AleSuky/SkP32v1.1/SW/Ejemplos/Microchip/USB/Documentation/images/LPCDK-J14.jpg

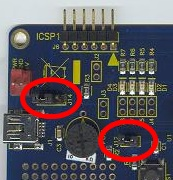
SW/Ejemplos/Microchip/USB/Documentation/images/LPCDK-J14.jpg
