AleSuky/SkP32v1.1/SW/Ejemplos/Microchip/USB/Documentation/images/FSUSBsw2.jpg

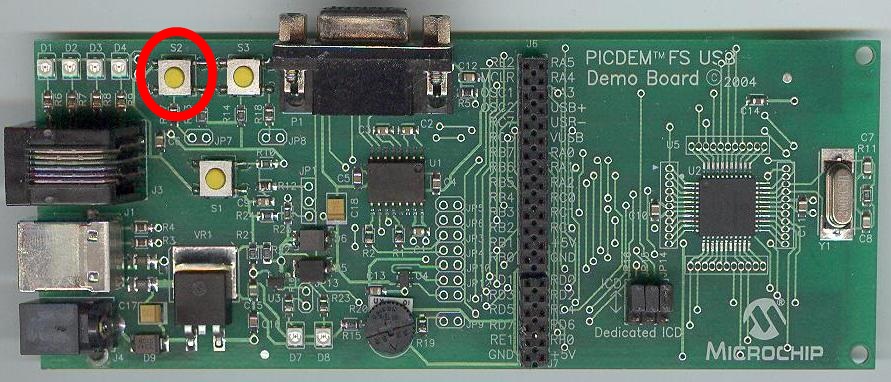
SW/Ejemplos/Microchip/USB/Documentation/images/FSUSBsw2.jpg
