AleSuky/SkP32v1.1/README.md

<b>SkP32</b>

<p>SkP32 es una placa desarrollo para PIC32MX3/4 y PIC24 con package TQFP100. Ha sido pensada especialmente para un PIC32, 
pero gracias a que Microchip mantiene el pinout entre familias, podemos decir que hay seguramente un 95% de compatibilidad 
para los PIC24.</p>

Las características de la misma son:

<ul>
<li type="square">Microcontrolador PIC32MX3/4 o PIC24</li>
<li type="square">Reguladores de 5.0 y 3.3 V.</li>
<li type="square">Alimentación externa o mediante USB.</li>
<li type="square">Header con disponibilidad de todos los pines del microcontrolador.</li>
<li type="square">Header para UART1 y UART2.</li>
<li type="square">Header para I2C1 e I2C2.</li>
<li type="square">Header para SPI1 y SPI2.</li>
<li type="square">Header para pines I/O RB0-RB7 (8-bits).</li>
<li type="square">Header para LCD TFT</li>
<li type="square">4 Leds on board habilitable mediantejumpers.</li>
<li type="square">2 Switch on board habilitable mediantejumpers.</li>
<li type="square">1 Potenciometro on board habilitable mediante jumper</li>
<li type="square">Para PIC con USB, conector mini-USB device</li>
<li type="square">Para PIC con USB, USB-A Host con TPS2041B para control sobre corriente.</li>
<li type="square">Zócalo para SD Card.</li>
<li type="square">Memoria EEPRON SPI (3.3 V).</li>
<li type="square">Cristal de 32768 Hz para RTC interno.</li>
<li type="square">Header para conexión ISCP.</li>
</ul>

<b>Ejemplos provistos:</b>
<ul>
<li type="square">Bootloader USB</li>
<li type="square">AVI_Player</li>	
<li type="square">FM25L16	</li>
<li type="square">FreeRTOS LCD</li>	
<li type="square">FreeRTOS Plantilla</li>
<li type="square">FSFatTest (FatFs by ChaN)</li>
<li type="square">Modbus Test (freeMODBUS)</li>	
<li type="square">Plantilla	</li>
<li type="square">RTC	</li>
<li type="square">SDCard	</li>
<li type="square">SST25VF016	</li>
<li type="square">TCPIP	</li>
<li type="square">TFT+ADC	</li>
<li type="square">TFT+Touch	</li>
<li type="square">UART</li>	
<li type="square">USB-CDC	</li>
<li type="square">USB-HID	</li>
<li type="square">USB-HOST_Mass_Storag</li>
<li type="square">USB-MST</li>
</ul>

<p>Copyright © Micros-Designs.com.ar</p>
