AleSuky/SkP32v1.1/HW/Eagle/SkP32v1.1.jpg

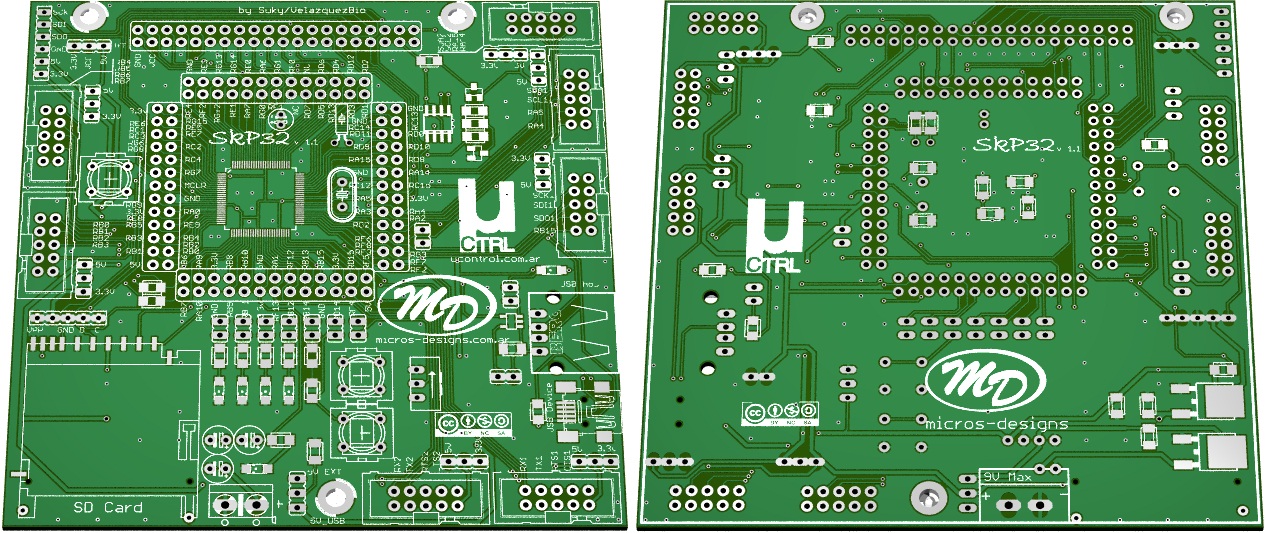
HW/Eagle/SkP32v1.1.jpg
