AleSuky/SkP32v1.1/SW/Ejemplos/Microchip/USB/Documentation/images/android_custom_hid.png

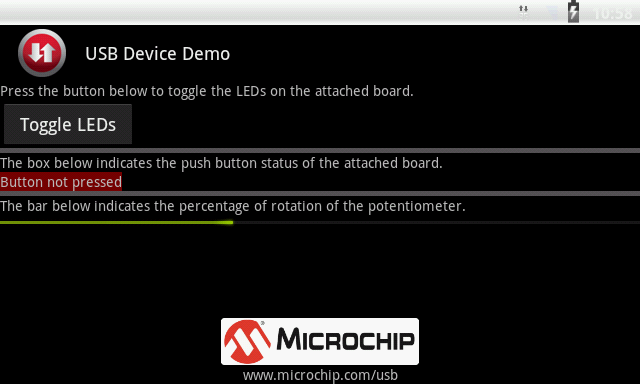
SW/Ejemplos/Microchip/USB/Documentation/images/android_custom_hid.png
