AleSuky/SkP32v1.1/SW/Ejemplos/Microchip/USB/Documentation/images/android_no_device.png

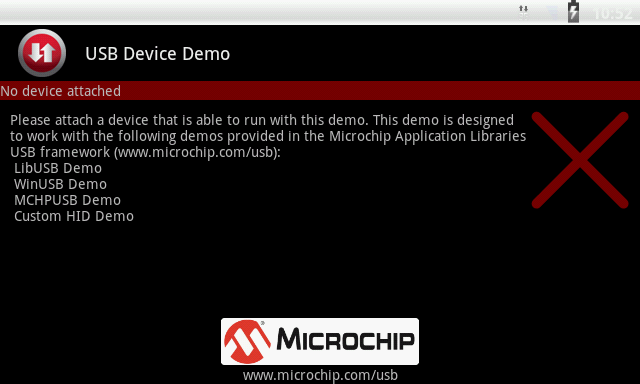
SW/Ejemplos/Microchip/USB/Documentation/images/android_no_device.png
