AleSuky/SkP32v1.1/SW/Ejemplos/Microchip/USB/Documentation/images/Application ld script.png

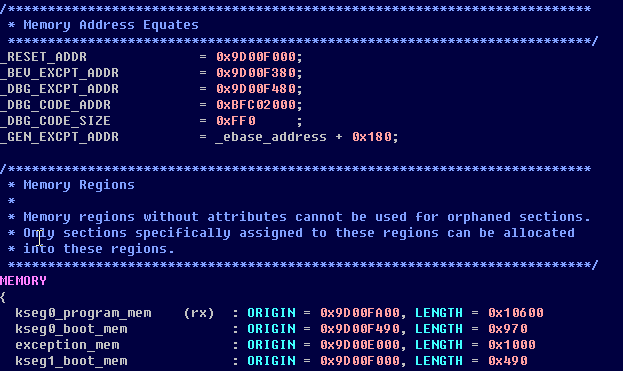
SW/Ejemplos/Microchip/USB/Documentation/images/Application ld script.png
