AleSuky/SkP32v1.1/SW/Ejemplos/Microchip/USB/Documentation/images/microchip_android_home.png

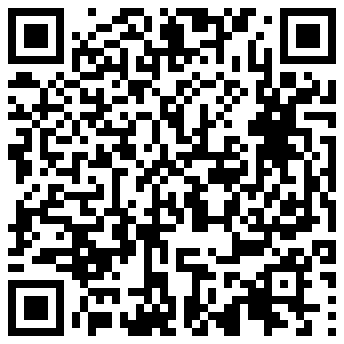
SW/Ejemplos/Microchip/USB/Documentation/images/microchip_android_home.png
