AleSuky/SkP32v1.1/SW/Ejemplos/Microchip/USB/Printer Host Driver/Documentation/Printer Study.xls

Sheet: Printers
Printer Languages Used By Popular Printers
Manufacturer | Model | Type | Cost | Not Available | Host-based | Epson Emulation | CPCL | DPL | EPL2 | ESC | ESC/P | ESC/P2 | ESC/POS | GDI | IBM 2380 Emulation | LIDIL | Okidata MICROLINE | PCL 3 | PCL 3 enhanced | PCL 3 GUI | PCL 5e | PCL 6/XL | PCL 10 (?) | PostScript 3 | PPDS | SPL or SPL-C | ZPL II
Count |  |  |  | 40 | 8 | 4 | 3 | 0 | 1 | 1 | 4 | 2 | 24 | 2 | 1 | 8 | 4 | 4 | 5 | 7 | 7 | 12 | 1 | 6 | 5 | 3 | 4
HP | Deskjet D2430 | Inkjet | $40 |  |  |  |  |  |  |  |  |  |  |  |  | X |  |  |  |  |  |  |  |  |  |  |  | Color Laser
HP | Deskjet D2530 | Inkjet | $40 |  |  |  |  |  |  |  |  |  |  |  |  |  |  |  |  | X |  |  |  |  |  |  |  | Dot Matrix Receipt
HP | Deskjet D2560 | Inkjet | $50 |  |  |  |  |  |  |  |  |  |  |  |  |  |  |  |  | X |  |  |  |  |  |  |  | Embedded
HP | Deskjet D2460 | Inkjet | $50 |  |  |  |  |  |  |  |  |  |  |  |  | X |  |  |  |  |  |  |  |  |  |  |  | Impact
HP | Deskjet D4260 | Inkjet | $70 |  |  |  |  |  |  |  |  |  |  |  |  | X |  |  |  |  |  |  |  |  |  |  |  | Inkjet
HP | Deskjet D1560 | Inkjet | $70 |  |  |  |  |  |  |  |  |  |  |  |  | X |  |  |  |  |  |  |  |  |  |  |  | Inkjet All-In-One
HP | Deskjet D1455 | Inkjet | $70 |  |  |  |  |  |  |  |  |  |  |  |  | X |  |  |  |  |  |  |  |  |  |  |  | Inkjet Receipt
HP | Deskjet 460c | Mobile | $250 |  |  |  |  |  |  |  |  |  |  |  |  |  |  |  | X |  |  |  |  |  |  |  |  | Laser
HP | Deskjet 470 | Mobile | $250 |  |  |  |  |  |  |  |  |  |  |  |  |  |  |  | X |  |  |  |  |  |  |  |  | Laser All-In-One
HP | Photosmart D5360 | Inkjet | $90 |  |  |  |  |  |  |  |  |  |  |  |  |  |  |  | X |  |  |  |  |  |  |  |  | Mobile
HP | Deskjet F4180 | Inkjet All-In-One | $80 |  |  |  |  |  |  |  |  |  |  |  |  | X |  |  |  |  |  |  |  |  |  |  |  | Mobile Receipt
HP | Deskjet 6940 | Inkjet | $110 | X |  |  |  |  |  |  |  |  |  |  |  |  |  |  |  |  |  |  |  |  |  |  |  | Photo Only
HP | Photosmart C4280 | Inkjet All-In-One | $100 | X |  |  |  |  |  |  |  |  |  |  |  |  |  |  |  |  |  |  |  |  |  |  |  | POS
HP | Photosmart C5280 | Inkjet All-In-One | $130 |  |  |  |  |  |  |  |  |  |  |  |  |  |  |  |  | X |  |  |  |  |  |  |  | Specialty
HP | Photosmart D7260 | Inkjet | $130 |  |  |  |  |  |  |  |  |  |  |  |  |  |  | X |  |  |  |  |  |  |  |  |  | Thermal
HP | Photosmart D7460 | Inkjet | $150 |  |  |  |  |  |  |  |  |  |  |  |  |  |  |  |  | X |  |  |  |  |  |  |  | Thermal Label
HP | Photosmart C4385 | Inkjet All-In-One | $130 |  |  |  |  |  |  |  |  |  |  |  |  |  |  | X |  | X |  |  | X |  |  |  |  | Thermal Receipt
HP | Deskjet 6988 | Inkjet | $130 |  |  |  |  |  |  |  |  |  |  |  |  |  |  | X
HP | Photosmart A526 | Photo Only | $100 |  |  |  |  |  |  |  |  |  |  |  |  |  |  | X
HP | Photosmart A440 | Photo Only | $100 |  |  |  |  |  |  |  |  |  |  |  |  |  |  |  |  | X
HP | Officejet 4315 | Inkjet All-In-One | $90 | X
HP | Officejet J3680 | Inkjet All-In-One | $90 |  |  |  |  |  |  |  |  |  |  |  |  | X
HP | Officejet J4580 | Inkjet All-In-One | $110 |  |  |  |  |  |  |  |  |  |  |  |  |  |  |  |  | X
HP | Officejet 5610 | Inkjet All-In-One | $110 |  |  |  |  |  |  |  |  |  |  |  |  | X
HP | Officejet Pro K5400 | Inkjet | $150 |  |  |  |  |  |  |  |  |  |  |  |  |  |  |  | X
HP | LaserJet P1005 | Laser | $130 |  | X
HP | Color LaserJet 1600 | Color Laser | $300 |  | X
HP | Officejet J5780 | Inkjet All-In-One | $150 |  |  |  |  |  |  |  |  |  |  |  |  |  |  |  | X
HP | Laserjet P1505 | Laser | $200 |  | X
HP | LaserJet P1505n | Laser | $250 |  | X |  |  |  |  |  |  |  |  |  |  |  |  |  |  |  | X
HP | LaserJet M1319f MFP | Laser All-In-One | $250 |  | X
HP | LaserJet P1106 | Laser | $180 |  | X
Lexmark | X2600 | Inkjet | $60 | X
Lexmark | X2470 | Inkjet All-In-One | $60 | X
Lexmark | X2500 | Inkjet All-In-One | $60 | X
Lexmark | X3550 | Inkjet | $80 | X
Lexmark | X5060 | Inkjet All-In-One | $90 | X
Lexmark | X5450 | Inkjet All-In-One | $90 | X
Lexmark | P4350 | Inkjet All-In-One | $100 | X
Lexmark | X4270 | Inkjet All-In-One | $100 | X
Lexmark | X5075 | Inkjet All-In-One | $100 | X
Lexmark | X5470 | Inkjet All-In-One | $100 | X
Lexmark | X5495 | Inkjet All-In-One | $100 | X
Lexmark | Z2420 | Inkjet | $80 | X
Lexmark | X4550 | Inkjet All-In-One | $130 | X
Lexmark | X4850 | Inkjet All-In-One | $140 | X
Lexmark | Forms Printer 2580 | Specialty | $370 |  |  | X |  |  |  |  |  |  |  |  |  |  | X |  |  |  |  |  |  |  | X
Lexmark | Forms Printer 2580n | Specialty | $520 |  |  | X |  |  |  |  |  |  |  |  |  |  | X |  |  |  |  |  |  |  | X
Lexmark | E120n | Laser | $150 |  |  |  |  |  |  |  |  |  |  |  |  |  |  |  |  |  | X | X
Lexmark | E250d | Laser | $200 |  |  |  |  |  |  |  |  |  |  |  |  |  |  |  |  |  | X | X
Lexmark | E250dn | Laser | $250 |  |  |  |  |  |  |  |  |  |  |  |  |  |  |  |  |  | X | X |  | X
Epson | LX-300+II | Impact | $205 |  |  |  |  |  |  | X |  |  |  |  | X
Epson | FX-2190 | Impact | $510 |  |  |  |  |  |  |  | X |  |  |  |  |  | X |  |  |  |  |  |  |  | X
Epson | LQ-590 | Impact | $310 |  |  |  |  |  |  |  |  | X |  |  |  |  |  |  |  |  |  |  |  |  | X
Epson | LQ-2090 | Impact | $490 |  |  |  |  |  |  |  |  | X |  |  |  |  |  |  |  |  |  |  |  |  | X
Epson | Stylus Photo R280 | Inkjet | $100 | X
Epson | Stylus Photo R380 | Inkjet | $130 | X
Epson | Stylus CX7400 | Inkjet All-In-One | $70 | X
Epson | Stylus CX8400 | Inkjet All-In-One | $100 | X
Epson | Stylus CX9400Fax | Inkjet All-In-One | $130 | X
Epson | TM-J8000 (1) | Inkjet Receipt |  |  |  |  |  |  |  |  |  |  | X
Epson | TM-J2000/2100 (1,2) | Inkjet Receipt |  |  |  |  |  |  |  |  |  |  | X
Epson | TM-J7000/J7100 (1,2) | Inkjet Receipt | $776 |  |  |  |  |  |  |  |  |  | X
Epson | TM-J7500/J7600 (1,2) | Inkjet Receipt |  |  |  |  |  |  |  |  |  |  | X
Epson | TM-T90 (1,2) | Thermal Receipt | $426 |  |  |  |  |  |  |  |  |  | X
Epson | TM-L90 (1,2) | Thermal Label |  |  |  |  |  |  |  |  |  |  | X
Epson | TM-T88IV (1,common) | Thermal Receipt | $325 |  |  |  |  |  |  |  |  |  | X
Epson | TM-U220 (1,2) | Dot Matrix Receipt | $316 |  |  |  |  |  |  |  |  |  | X
Epson | TM-U200 (1,2) | Dot Matrix Receipt |  |  |  |  |  |  |  |  |  |  | X
Epson | TM-U325 (1) | Dot Matrix Receipt | $365 |  |  |  |  |  |  |  |  |  | X
Epson | TM-U675 (1) | Dot Matrix Receipt | $583 |  |  |  |  |  |  |  |  |  | X
Epson | TM-U230 (1,kitchen) | Dot Matrix Receipt |  |  |  |  |  |  |  |  |  |  | X
Epson | TM-U590 | Dot Matrix Receipt |  |  |  |  |  |  |  |  |  |  | X
Epson | TM-H5000II Hybrid (1) | Dot Matrix Receipt |  |  |  |  |  |  |  |  |  |  | X
Epson | TM-H6000II Hybrid (1) | Dot Matrix Receipt | $738 |  |  |  |  |  |  |  |  |  | X
Epson | EU-T400 | Embedded |  |  |  |  |  |  |  |  |  |  | X
Epson | EU-T532/T542 | Embedded |  |  |  |  |  |  |  |  |  |  | X
Seiko | DPU-V445 | Thermal |  |  |  |  |  |  |  |  |  |  | X
Seiko | MPU-L465 | Thermal | $887 |  |  |  |  |  |  |  |  |  | X
Seiko | DPU-S445 | Thermal |  |  |  |  |  |  |  |  | X
Zebra | MZ220 | Mobile Receipt | $396 |  |  |  | X
Zebra | MZ320 | Mobile Receipt | $820 |  |  |  | X
Zebra | RW220 | Mobile Receipt | $806 |  |  |  | X |  | X
Zebra | LP 2824-Z | Thermal Label |  |  |  |  |  |  |  |  |  |  |  |  |  |  |  |  |  |  |  |  |  |  |  |  | X
Zebra | TLP 2824-Z | Thermal Label |  |  |  |  |  |  |  |  |  |  |  |  |  |  |  |  |  |  |  |  |  |  |  |  | X
Zebra | LP 2844-Z | Thermal Label |  |  |  |  |  |  |  |  |  |  |  |  |  |  |  |  |  |  |  |  |  |  |  |  | X
Zebra | TLP 2844-Z | Thermal Label |  |  |  |  |  |  |  |  |  |  |  |  |  |  |  |  |  |  |  |  |  |  |  |  | X
Bixolon (Samsung) | SPP-R200 | Mobile Receipt | $340 |  |  |  |  |  |  |  |  |  | X
Bixolon (Samsung) | SRP-350plus | Thermal Receipt | $240 |  |  |  |  |  |  |  |  |  | X
Citizen | CT-S310 | Thermal Receipt | $220 |  |  |  |  |  |  |  |  |  | X
Citizen | CT-S2000 | Thermal Receipt |  |  |  |  |  |  |  |  |  |  | X
Citizen | CT-S4000 | Thermal Receipt |  |  |  |  |  |  |  |  |  |  | X
Canon | PIXMA iP2600 | Inkjet | $50 | X
Canon | PIXMA iP1800 | Inkjet | $50 | X
Canon | PIXMA iP3500 | Inkjet | $80 | X
Canon | PIXMA iP4500 | Inkjet | $130 | X
Canon | BJC-85 | Mobile | $400 | X
Canon | PIXMA iP90v | Mobile | $250 | X
Brother | QL-1060N | Thermal Label | $250 |  |  |  |  |  |  |  | X
Brother | HL-2140 | Laser | $120 |  |  |  |  |  |  |  |  |  |  | X
Brother | HL-2170W | Laser | $150 |  |  |  |  |  |  |  |  |  |  |  |  |  |  |  |  |  |  | X
Brother | HL-5240 | Laser | $200 |  |  |  |  |  |  |  |  |  |  |  |  |  |  |  |  |  |  | X |  | X
Brother | HL-5250DN | Laser | $250 |  |  |  |  |  |  |  |  |  |  |  |  |  |  |  |  |  |  | X |  | X
Brother | DCP-7020 | Laser All-In-One | $180 |  | X
Okidata | B2200 | Laser | $110 |  |  |  |  |  |  |  |  |  |  | X
Okidata | B2400 | Laser | $160 |  |  |  |  |  |  |  |  |  |  |  |  |  |  |  |  |  | X | X
Okidata | B4400 | Laser | $230 |  |  |  |  |  |  |  |  |  |  |  |  |  |  |  |  |  | X | X
Okidata | B4600 | Laser | $300 |  |  |  |  |  |  |  |  |  |  |  |  |  |  |  |  |  | X | X
Okidata | Microline 186 | Impact | $320 |  |  |  |  |  |  |  | X |  |  |  |  |  | X
Xerox | Phaser 3124 | Laser | $180 |  | X
Dell | 810 | Inkjet All-In-One | $70 | X
Dell | 926 | Inkjet All-In-One | $100 | X
Dell | 948 | Inkjet All-In-One | $150 | X
Dell | 966 | Inkjet All-In-One | $180 | X
Dell | 968 | Inkjet All-In-One | $220 | X
DYMO | LabelWriter 400 Turbo | Specialty | $110 | X
DYMO | LabelWriter 400 Turbo | Specialty | $140 | X
DYMO | LabelWriter Twin Turbo | Specialty | $190 | X
DYMO | LabelWriter DUO | Specialty | $210 | X
Kodak | ESP 3 | Inkjet All-In-One | $130 | X
Kodak | 5100 | Inkjet All-In-One | $110 | X
Kodak | 5300 | Inkjet All-In-One | $150 | X
Samsung | ML-2510 | Laser | $90 |  |  |  |  |  |  |  |  |  |  |  |  |  |  |  |  |  |  |  |  |  |  | X
Samsung | ML-2851ND | Laser | $220 |  |  | X |  |  |  |  |  |  |  |  |  |  |  |  |  |  |  | X |  | X
Samsung | ML-2571N | Laser | $130 |  |  |  |  |  |  |  |  |  |  |  |  |  |  |  |  |  |  | X |  | X
Samsung | ML-1630 | Laser | $200 |  |  |  |  |  |  |  |  |  |  |  |  |  |  |  |  |  |  |  |  |  |  | X
Samsung | ML-3051ND | Laser | $240 |  |  | X |  |  |  |  |  |  |  |  |  |  |  |  |  |  |  | X |  | X
Samsung | CLP-300N | Color Laser | $300 |  |  |  |  |  |  |  |  |  |  |  |  |  |  |  |  |  |  |  |  |  |  | X
(1) USB is a dealer option
(2) 2 color, may require special paper

Sheet: Protocols
Printer Command Languages
Protocol | Information | Have Spec
CPCL | (Have spec)
 | Used by Zebra mobile printers.
DPL | (Have spec)
EPL2 | (Have spec)
ESC/P | Wikipedia: developed by Epson to control computer printers. It was mainly used in dot matrix printers and some inkjet printers. Modern printers no longer use ESC/P. | Yes
ESC/P2 | (Have spec)
 | Wikipedia: backward compatible to ESC/P, but adds commands for new printer features such as scalable fonts and enhanced graphics printing. Modern printers no longer use ESC/P.
ESC/POS | (Getting spec(s))
 | Used by all Epson POS printers, which make up 52% of the market. Is also used by other manufactures. The closest thing to a POS printer standard language.
GDI | Wikipedia: A GDI printer ... is a print processor that uses software to do all the print processing instead of requiring the printer hardware to do it. It works by rendering an image to a bitmap on the host computer and then sending the bitmap to the printer. This allows low-cost printers to be built by printer manufacturers, because all the page composition is done in software. Usually, such printers do not natively support a page description language such as PostScript or XPS.
LIDIL | Lightweight Imaging Device Interface Language; Wikipedia: This language is commonly used on HP Deskjets that do not support the PCL printer language. As the name suggests, the language only supports the definition of raster documents, and is very limited overall. It is a "host-based" protocol which is advertised with LDL in the CMD: (command set) field of the device ID string. Such models do not support printing ASCII text.
PCL 1 | Wikipedia: Introduced in 1984 on the HP ThinkJet 2225 and provides basic text and graphics printing with a maximum resolution of 150 dpi (dots per inch).
 | http://www.csgnetwork.com/hppclhist.html: This version is supported by all HP LaserJet series printers (except the HP LaserJet 3100 and 3150 series products). It provided very basic printing and spacing functionality, but was limited to only text printing and ASCII characters. PCL 1 is the foundational base set of functions provided for simple, single-user workstation output. It was created in the late 1970s and introduced in the late 70s and early 80s.
PCL 1+ | Wikipedia: released with the HP QuietJet 2227
PCL 2 | Wikipedia: added Electronic Data Processing/Transaction functionality.
 | http://www.csgnetwork.com/hppclhist.html: As was PCL 1, this version is supported by all HP LaserJet series printers (except the HP LaserJet 3100 and 3150 series products). Hence it covered all PCL functionality and provided Electronic Data Processing/Transaction functionality. Functions were added for general purpose, multi-user system printing, but still in ASCII printing only. It was Introduced in the early part of 1982.
PCL 3 | Wikipedia: introduced in 1984 with the original HP LaserJet. This added support for bitmap fonts and increased the maximum resolution to 300 dpi. Other products with PCL 3 support were the HP DeskJet ink jet printer, HP 2932 series matrix printers and HP RuggedWriter 2235 matrix printers. PCL 3 is still in use on several impact printers which replaced the obsoleted HP models.
 | http://www.csgnetwork.com/hppclhist.html: This was the first of the intelligent series of efforts by HP to incorporate graphics, crude as they were back then. It was the embedded code for the original HP LaserJet series printer, and the HP LaserJet Plus series printer. This version provided the commands and features required for simple high quality word processing and data printing. Allowed for the use of a limited number of bitmapped fonts and graphics. It quickly rost to the position of industry standard and PCL 3 was widely imitated by other printer manufacturers, commonly referred to as "LaserJet Plus Emulation" when used by other companies. It came out in 1984.
PCL 3+ | Wikipedia: used on later HP DeskJet and HP PhotoSmart products.
PCL 3 GUI | Wikipedia: used in the HP DesignJet and some DeskJet series printers. It uses a compressed raster format that is not compatible with standard PCL 3.
PCL 4 | Wikipedia: introduced on the HP LaserJet II in 1985, adding macros, larger bitmapped fonts and graphics. PCL 4 is still popular for many applications.
 | http://www.csgnetwork.com/hppclhist.html: This industry standard release was the embedded code for the HP LaserJet Series II, commonly referred to as the workhorse laser, the HP LaserJet IID, HP LaserJet IIP, and HP LaserJet IIP Plus. It had a host of new page printing capabilities, including support for macros, larger bitmapped fonts and graphics. Introduced in 1985, it was the most radical of version improvements and would be more than sufficient for users for several years.
PCL 5 | (Have spec) | Yes
 | Wikipedia: released on the HP LaserJet III in March 1990, adding Intellifont font scaling (developed by Compugraphic, now part of Agfa), outline fonts and HP-GL/2 (vector) graphics.
 | http://www.csgnetwork.com/hppclhist.html: As the foundation of the HP LaserJet III, HP LaserJet IIID, HP LaserJet IIIP, and HP LaserJet IIISI, PCL 5 provided ultimate office publishing functionality. It was released to allow compatibility for industry acceptance for font scaling, outline fonts and HP-GL/2 (vector) graphics. PCL 5 was designed for more complex desktop publishing, graphic design, and presentation applications. Introduced in mid-1990 with the HP LaserJet III, this is the most widely used version of PCL compatibility in use by customers.
PCL 5e | Wikipedia: released on the HP LaserJet 4 in October 1992 and added bi-directional communication between the printer and the PC and Windows fonts.
 | http://www.csgnetwork.com/hppclhist.html: Though it was labeled an enhancement to PCL 5, it was the internal code released with the HP LaserJet 4, HP LaserJet 4M, HP LaserJet 4L, HP LaserJet 4ML, HP LaserJet 4P, HP LaserJet 4MP, HP LaserJet 4Plus, HP LaserJet 4Mplus, HP LaserJet 5P, HP LaserJet 5MP, HP LaserJet 5L, HP LaserJet 5L-FS, HP LaserJet 5Lxtra, HP LaserJet 6L, HP LaserJet 6LXI, HP LaserJet 6LSE, HP LaserJet 6P, HP LaserJet 6MP, HP LaserJet 6PXI, HP LaserJet 6PSE and HP LaserJet 5si. HP LaserJet 8000 series, HP LaserJet 9000 series printers. It had major improvements and changes including bidirectional communication between the printer and the PC. It featured a wider selection of fonts for use primarily with the Microsoft Windows environment and applications.
PCL 5c | Wikipedia: introduced color support on the HP PaintJet 300XL and HP Color LaserJet in 1992.
 | http://www.csgnetwork.com/hppclhist.html: This was also an enhancement to PCL 5 to add functional color support for HP Color LaserJet, HP Color LaserJet 5, HP Color LaserJet 5M, HP Color LaserJet 2500 series, HP Color LaserJet 4500 series, HP Color LaserJet 4550 series, HP Color LaserJet 4600 series, HP Color LaserJet 5500 series, HP Color LaserJet 8500 series and HP Color LaserJet 8550 series printers. It offered no other changes except the commands needed to support color printing.
PCL 6 | Wikipedia: (aka PCL XL), introduced around 1995, features a new modular architecture that can be easily modified for future HP printers; faster return to application; faster printing of complex graphics; more efficient data streams for reduced network traffic; better WYSIWYG printing; improved print quality; and complete backward compatibility. Some products may claim to be PCL 6 compliant, but may not include the PCL 5 backward compatibility.
 | HP: PCL6 is very different from PCL5 and previous PCL versions. One significant difference is the manner in which the commands are sent to the printer.
 | http://www.tek-tips.com/viewthread.cfm?qid=1057953&page=1: PCL5/PCL5e (the latter being an extended version) is an escape-based language, using an ASCII representation, but is relatively unstructured (although quite powerful); so you can edit a PCL5 print stream relatively easily. PCL6 (aka PCL XL) is a completely different language, uses a binary representation, and is much more structured; for these reasons, it is much more difficult to edit a PCL6 print stream. PCL XL has a closer relationshipt to the GDI used within Windows than does PCL5; most PCL6 drivers now offer more features than their PCL5 equivalents. HP (for reasons known only to themselves) do not publish a PCL6 equivalent to the PCL5 Technical Reference manual; there is little PCL6 documentation available publically.
 | http://www.csgnetwork.com/hppclhist.html: This version offered significan changes in the backward compatibility issue for HP. PCL6 is very different from PCL5 and previous PCL versions. One significant difference is the manner in which the commands are sent to the printer. The target was performance and reliability; the jury is still out on the question of better. Prior to PCL 6, each new version of the language included commands not found in older versions as well as the older PCL commands. As a result, printers with more recent versions of PCL are backwards compatible with software that supports older versions of the language. PCL 6 was released with the HP LaserJet 4000 series, HP LaserJet 4100 series, HP LaserJet 2100 series, HP LaserJet 2200 series, HP LaserJet 1200, HP LaserJet 3200, HP LaserJet 3300, HP LaserJet 4200 series, HP LaserJet 4300 series, HP LaserJet 5000 series, HP LaserJet 5100 series, HP LaserJet 8000 series and HP LaserJet 9000 series printers. PCL 6 features new modular architecture that can be easily modified for future HP printers. The efforts for faster, post printing return to application have made somewhat of a problem with older operating systems. Other performance efforts are faster printing of complex graphics, more efficient data streams for reduced network traffic, better WYSIWYG printing, improved print quality, truer document fidelity, and complete backward compatibility. The compatibility issues have caused many users to select PCL 5 as t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
PostScript | (Have spec) | Yes
SPL | Samsung Print Language, or SPL-C (color)
ZPL | (Have spec)
 | Used by Zebra, mostly expensive label printers
