AleSuky/SkP32v1.1/SW/Ejemplos/Microchip/USB/Printer Host Driver/Documentation/Printers.xls

Sheet: By Model
Printer | CMD | Note
HP Deskjet D4150 (Eric's) | LDL,DYN | Analyzer Data
HP Laserjet 3500 | PJL,PML,DW-PCL,JR4.0 | Analyzer Data
Lexmark X73 | LNPAP | Analyzer Data
Canon PIXMA iP4300 | BJL,BJRaster3,BSCCe | Analyzer Data
Lexmark Z42 | LNPAP | Web
Lexmark Z22-Z32 | LNPAP | Web
Canon BJ M40 | BJ,BJL,BJRaster,BSCC | Web
hp color LaserJet 4650 | PJL,MLC,BIDI-ECP,PCLXL,PCL,PDF,PJL,MIME,POSTSCRIPT | Web
EPSON Stylus D78 | ESCPL2,BDC,D4,D4PX | Web
HP PSC 2200 Series | MLC,PCL,PML,DW-PCL,DYN | Web
Hewlett-Packard DeskJet 990C | MLC,PCL,PML | Web
Hewlett-Packard LaserJet 6MP Printer | PJL,MLC,PCLXL,PCL,POSTSCRIPT | Web
Canon iP3000 | BJL,BJRaster3,BSCCe | Web
HP Deskjet 5400 series | MLC,PCL,PML,DW-PCL,DESKJET,DYN | Web
HP LaserJet 1020 | ACL;CLS | Web
Kodac 8500 Digital Photo Printer | KOD | Web
Hewlett-Packard LaserJet 3390 | PJL,PML,MLC,POSTSCRIPT,PCLXL,PCL | Web

Sheet: By CMD
ACL | BDC | BIDI-ECP | BJ | BJL | BJRaster | BJRaster3 | BSCC | BSCCe | CLS | D4 | D4PX | DESKJET | DW-PCL | DYN | ESCPL2 | JR4.0 | KOD | LDL | LNPAP | MIME | MLC | PCL | PCLXL | PDF | PJL | PML | POSTSCRIPT
HP LaserJet 1020 | EPSON Stylus D78 | hp color LaserJet 4650 | Canon BJ M40 | Canon PIXMA iP4300 | Canon BJ M40 | Canon PIXMA iP4300 | Canon BJ M40 | Canon PIXMA iP4300 | HP LaserJet 1020 | EPSON Stylus D78 | EPSON Stylus D78 | HP Deskjet 5400 series | HP Laserjet 3500 | HP Deskjet D4150 (Eric's) | EPSON Stylus D78 | HP Laserjet 3500 | Kodac 8500 Digital Photo Printer | HP Deskjet D4150 (Eric's) | Lexmark X73 | hp color LaserJet 4650 | hp color LaserJet 4650 | hp color LaserJet 4650 | hp color LaserJet 4650 | hp color LaserJet 4650 | HP Laserjet 3500 | HP Laserjet 3500 | hp color LaserJet 4650
 |  |  |  | Canon BJ M40 |  | Canon iP3000 |  | Canon iP3000 |  |  |  |  | HP PSC 2200 Series | HP PSC 2200 Series |  |  |  |  | Lexmark Z42 |  | HP PSC 2200 Series | HP PSC 2200 Series | Hewlett-Packard LaserJet 6MP Printer |  | hp color LaserJet 4650 | HP PSC 2200 Series | Hewlett-Packard LaserJet 6MP Printer
 |  |  |  | Canon iP3000 |  |  |  |  |  |  |  |  | HP Deskjet 5400 series | HP Deskjet 5400 series |  |  |  |  | Lexmark Z22-Z32 |  | Hewlett-Packard DeskJet 990C | Hewlett-Packard DeskJet 990C | Hewlett-Packard LaserJet 3390 |  | Hewlett-Packard LaserJet 6MP Printer | Hewlett-Packard DeskJet 990C | Hewlett-Packard LaserJet 3390
 |  |  |  |  |  |  |  |  |  |  |  |  |  |  |  |  |  |  |  |  | Hewlett-Packard LaserJet 6MP Printer | Hewlett-Packard LaserJet 6MP Printer | Hewlett-Packard LaserJet 3390 |  | Hewlett-Packard LaserJet 3390 | HP Deskjet 5400 series
 |  |  |  |  |  |  |  |  |  |  |  |  |  |  |  |  |  |  |  |  | HP Deskjet 5400 series | HP Deskjet 5400 series |  |  |  | Hewlett-Packard LaserJet 3390
 |  |  |  |  |  |  |  |  |  |  |  |  |  |  |  |  |  |  |  |  | Hewlett-Packard LaserJet 3390 | Hewlett-Packard LaserJet 3390
