AleSuky/SkP32v1.1/SW/Ejemplos/TCPIP/Demo App/HardwareProfile.h

/*********************************************************************
 *
 *	Hardware specific definitions
 *
 *********************************************************************
 * FileName:        HardwareProfile.h
 * Dependencies:    None
 * Processor:       PIC18, PIC24F, PIC24H, dsPIC30F, dsPIC33F, PIC32
 * Compiler:        Microchip C32 v1.10 or higher
 *					Microchip C30 v3.12 or higher
 *					Microchip C18 v3.34 or higher
 *					HI-TECH PICC-18 PRO 9.63PL2 or higher
 * Company:         Microchip Technology, Inc.
 *
 * Software License Agreement
 *
 * Copyright (C) 2002-2010 Microchip Technology Inc.  All rights
 * reserved.
 *
 * Microchip licenses to you the right to use, modify, copy, and
 * distribute:
 * (i)  the Software when embedded on a Microchip microcontroller or
 *      digital signal controller product ("Device") which is
 *      integrated into Licensee's product; or
 * (ii) ONLY the Software driver source files ENC28J60.c, ENC28J60.h,
 *		ENCX24J600.c and ENCX24J600.h ported to a non-Microchip device
 *		used in conjunction with a Microchip ethernet controller for
 *		the sole purpose of interfacing with the ethernet controller.
 *
 * You should refer to the license agreement accompanying this
 * Software for additional information regarding your rights and
 * obligations.
 *
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
 *
 * Author               Date		Comment
 *~~~~~~~~~~~~~~~~~~~~~~~~~~~~~~~~~~~~~~~~~~~~~~~~~~~~~~~~~~~~~~~~~~~~
 * Howard Schlunder		09/01/2010	Converted to a stub
 ********************************************************************/

// These definitions are set in the MPLAB Project settings.  If you are starting
// a new project, you should start by modifying one of the pre-existing .mcp 
// files.  To modify the macro used, in MPLAB IDE, click on Project -> Build 
// Options... -> Project -> MPLAB XXX C Compiler -> Preprocessor Macros -> 
// Add.... Note that you may also have to add this macro to the assembler 
// (MPLAB XXX Assembler tab).
#ifndef HARDWARE_PROFILE_H
#define HARDWARE_PROFILE_H

#include "Compiler.h"

// Define a macro describing this hardware set up (used in other files)
#define SkP32

// Set configuration fuses (but only in MainDemo.c where THIS_IS_STACK_APPLICATION is defined)
#if defined(THIS_IS_STACK_APPLICATION)
	#pragma config FPLLODIV=DIV_1, FPLLIDIV=DIV_2, FPLLMUL=MUL_20, FPBDIV=DIV_1
	#pragma config FWDTEN=OFF, FCKSM=CSDCMD, POSCMOD=XT, FNOSC=PRIPLL
	#pragma config CP=OFF, BWP=OFF, PWP=OFF
#endif


// Clock frequency values
// These directly influence timed events using the Tick module.  They also are used for UART and SPI baud rate generation.
#define GetSystemClock()		(80000000ul)			// Hz
#define GetInstructionClock()	(GetSystemClock()/1)	// Normally GetSystemClock()/4 for PIC18, GetSystemClock()/2 for PIC24/dsPIC, and GetSystemClock()/1 for PIC32.  Might need changing if using Doze modes.
#define GetPeripheralClock()	(GetSystemClock()/1)	// Normally GetSystemClock()/4 for PIC18, GetSystemClock()/2 for PIC24/dsPIC, and GetSystemClock()/1 for PIC32.  Divisor may be different if using a PIC32 since it's configurable.


// Hardware I/O pin mappings

// LEDs
#define LED0_TRIS			(TRISBbits.TRISB8)	// Ref LED1
#define LED0_IO				(LATBbits.LATB8)
#define LED1_TRIS			(TRISBbits.TRISB9)	// Ref LED2
#define LED1_IO				(LATBbits.LATB9)
#define LED2_TRIS			(TRISBbits.TRISB10)	// Ref LED3
#define LED2_IO				(LATBbits.LATB10)
#define LED3_TRIS			(TRISBbits.TRISB11)	// Ref LED4
#define LED3_IO				(LATBbits.LATB11)
#define LED4_TRIS			(TRISBbits.TRISB11)			// No such LED
#define LED4_IO				(LATBbits.LATB11)
#define LED5_TRIS			(TRISBbits.TRISB11)			// No such LED
#define LED5_IO				(LATBbits.LATB11)
#define LED6_TRIS			(TRISBbits.TRISB11)			// No such LED
#define LED6_IO				(LATBbits.LATB11)
#define LED7_TRIS			(TRISBbits.TRISB11)			// No such LED
#define LED7_IO				(LATBbits.LATB11)
#define LED_GET()			((PORTB & 0x0F00)>>8)
#define LED_PUT(a)			do{LATB = (LATB & 0xF0FF) | ((unsigned int)((a)&0x0F)<<8);}while(0)

// Momentary push buttons
#define BUTTON0_TRIS		(TRISBbits.TRISB12)	// Ref SW1
#define BUTTON0_IO			(PORTBbits.RB12)
#define BUTTON1_TRIS		(TRISBbits.TRISB13)	// Ref SW2
#define BUTTON1_IO			(PORTBbits.RB13)
#define BUTTON2_TRIS		(TRISBbits.TRISB13)	// No BUTTON
#define BUTTON2_IO			(1)
#define BUTTON3_TRIS		(TRISBbits.TRISB13)	// No BUTTON
#define BUTTON3_IO			(1)

// UART configuration (not too important since we don't have a UART 
// connector attached normally, but needed to compile if the STACK_USE_UART 
// or STACK_USE_UART2TCP_BRIDGE features are enabled.
#define UARTTX_TRIS			(TRISFbits.TRISF3)
#define UARTRX_TRIS			(TRISFbits.TRISF2)


// Specify which SPI to use for the ENC28J60 or ENC624J600.  SPI1 is 
// the topmost slot with pin 1 on it.  SPI2 is the middle slot 
// starting on pin 33.
//#define ENC_IN_SPI1
#define ENC_IN_SPI2

// ENC28J60 I/O pins
#if defined ENC_IN_SPI1
	#define ENC_CS_TRIS			(TRISBbits.TRISB4)
	#define ENC_CS_IO			(LATBbits.LATB4)
	//#define ENC_RST_TRIS		(TRISDbits.TRISD15)	// Not connected by default.  It is okay to leave this pin completely unconnected, in which case this macro should simply be left undefined.
	//#define ENC_RST_IO		(PORTDbits.RD15)

	// SPI SCK, SDI, SDO pins are automatically controlled by the 
	#define ENC_SPI_IF			(IFS0bits.SPI1RXIF)
	#define ENC_SSPBUF			(SPI1BUF)
	#define ENC_SPICON1			(SPI1CON)
	#define ENC_SPICON1bits		(SPI1CONbits)
	#define ENC_SPIBRG			(SPI1BRG)
	#define ENC_SPISTATbits		(SPI1STATbits)
#elif defined ENC_IN_SPI2
	#define ENC_CS_TRIS			(TRISBbits.TRISB4)
	#define ENC_CS_IO			(PORTBbits.RB4)
	//#define ENC_RST_TRIS		(TRISBbits.TRISB5)	// Not connected by default.  It is okay to leave this pin completely unconnected, in which case this macro should simply be left undefined.
	//#define ENC_RST_IO			(LATBbits.LATB5)

	// SPI SCK, SDI, SDO pins are automatically controlled by the 
	// PIC32 SPI module 
	#define ENC_SPI_IF			(IFS1bits.SPI2RXIF)
	#define ENC_SSPBUF			(SPI2BUF)
	#define ENC_SPICON1			(SPI2CON)
	#define ENC_SPISTATbits		(SPI2STATbits)
	#define ENC_SPICON1bits		(SPI2CONbits)
	#define ENC_SPIBRG			(SPI2BRG)
#endif


//// ENC624J600 Interface Configuration
//// Comment out ENC100_INTERFACE_MODE if you don't have an ENC624J600 or 
//// ENC424J600.  Otherwise, choose the correct setting for the interface you 
//// are using.  Legal values are:
////  - Commented out: No ENC424J600/624J600 present or used.  All other 
////                   ENC100_* macros are ignored.
////  - 0: SPI mode using CS, SCK, SI, and SO pins
////  - 1: 8-bit demultiplexed PSP Mode 1 with RD and WR pins
////  - 2: 8-bit demultiplexed PSP Mode 2 with R/Wbar and EN pins
////  - 3: 16-bit demultiplexed PSP Mode 3 with RD, WRL, and WRH pins
////  - 4: 16-bit demultiplexed PSP Mode 4 with R/Wbar, B0SEL, and B1SEL pins
////  - 5: 8-bit multiplexed PSP Mode 5 with RD and WR pins
////  - 6: 8-bit multiplexed PSP Mode 6 with R/Wbar and EN pins
////  - 9: 16-bit multiplexed PSP Mode 9 with AL, RD, WRL, and WRH pins
////  - 10: 16-bit multiplexed PSP Mode 10 with AL, R/Wbar, B0SEL, and B1SEL 
////        pins
//#define ENC100_INTERFACE_MODE			0
//
//// If using a parallel interface, direct RAM addressing can be used (if all 
//// addresses wires are connected), or a reduced number of pins can be used 
//// for indirect addressing.  If using an SPI interface or PSP Mode 9 or 10 
//// (multiplexed 16-bit modes), which require all address lines to always be 
//// connected, then this option is ignored. Comment out or uncomment this 
//// macro to match your hardware connections.
//#define ENC100_PSP_USE_INDIRECT_RAM_ADDRESSING
//
//// ENC424J600/624J600 parallel indirect address remapping macro function.
//// This section translates SFR and RAM addresses presented to the 
//// ReadMemory() and WriteMemory() APIs in ENCX24J600.c to the actual 
//// addresses that must be presented on the parallel interface.  This macro 
//// must be modified to match your hardware if you are using an indirect PSP 
//// addressing mode (ENC100_PSP_USE_INDIRECT_RAM_ADDRESSING is defined) and 
//// have some of your address lines tied off to Vdd.  If you are using the 
//// SPI interface, then this section can be ignored or deleted.
//#if (ENC100_INTERFACE_MODE == 1) || (ENC100_INTERFACE_MODE == 2) || (ENC100_INTERFACE_MODE == 5) || (ENC100_INTERFACE_MODE == 6) // 8-bit PSP
//	#define ENC100_TRANSLATE_TO_PIN_ADDR(a)		((((a)&0x0100)<<6) | ((a)&0x00FF))
//#elif (ENC100_INTERFACE_MODE == 3) || (ENC100_INTERFACE_MODE == 4) // 16-bit PSP
//	#define ENC100_TRANSLATE_TO_PIN_ADDR(a)		(a)
//#endif
//
//// Auto-crossover pins on Fast 100Mbps Ethernet PICtail/PICtail Plus.  If 
//// your circuit doesn't have such a feature, delete these two defines.
//#define ENC100_MDIX_TRIS				(TRISBbits.TRISB3)
//#define ENC100_MDIX_IO					(LATBbits.LATB3)
//
//// ENC624J600 I/O control and status pins
//// If a pin is not required for your selected ENC100_INTERFACE_MODE 
//// interface selection (ex: WRH/B1SEL for PSP modes 1, 2, 5, and 6), then 
//// you can ignore, delete, or put anything for the pin definition.  Also, 
//// the INT and POR pins are entirely optional.  If not connected, comment 
//// them out.
//#define ENC100_INT_TRIS					(TRISEbits.TRISE9)		// INT signal is optional and currently unused in the Microchip TCP/IP Stack.  Leave this pin disconnected and comment out this pin definition if you don't want it.
//#define ENC100_INT_IO					(PORTEbits.RE9)
//#if (ENC100_INTERFACE_MODE >= 1)	// Parallel mode
//	// PSP control signal pinout
//	#define ENC100_CS_TRIS					(TRISAbits.TRISA5)	// CS is optional in PSP mode.  If you are not sharing the parallel bus with another device, tie CS to Vdd and comment out this pin definition.
//	#define ENC100_CS_IO					(LATAbits.LATA5)
//	#define ENC100_POR_TRIS					(TRISCbits.TRISC1)	// POR signal is optional.  If your application doesn't have a power disconnect feature, comment out this pin definition.
//	#define ENC100_POR_IO					(LATCbits.LATC1)
//	#define ENC100_SO_WR_B0SEL_EN_TRIS		(TRISDbits.TRISD4)
//	#define ENC100_SO_WR_B0SEL_EN_IO		(LATDbits.LATD4)
//	#define ENC100_SI_RD_RW_TRIS			(TRISDbits.TRISD5)
//	#define ENC100_SI_RD_RW_IO				(LATDbits.LATD5)
//	#define ENC100_SCK_AL_TRIS				(TRISBbits.TRISB15)
//	#define ENC100_SCK_AL_IO				(LATBbits.LATB15)
//#else
//	// SPI pinout
//	#if defined ENC_IN_SPI1
//		#define ENC100_CS_TRIS					(TRISDbits.TRISD14)	// CS is mandatory when using the SPI interface
//		#define ENC100_CS_IO					(LATDbits.LATD14)
//		#define ENC100_POR_TRIS					(TRISDbits.TRISD15)	// POR signal is optional.  If your application doesn't have a power disconnect feature, comment out this pin definition.
//		#define ENC100_POR_IO					(LATDbits.LATD15)
//		#define ENC100_SO_WR_B0SEL_EN_TRIS		(TRISFbits.TRISF7)	// SO is ENCX24J600 Serial Out, which needs to connect to the PIC SDI pin for SPI mode
//		#define ENC100_SO_WR_B0SEL_EN_IO		(PORTFbits.RF7)
//		#define ENC100_SI_RD_RW_TRIS			(TRISFbits.TRISF8)	// SI is ENCX24J600 Serial In, which needs to connect to the PIC SDO pin for SPI mode
//		#define ENC100_SI_RD_RW_IO				(LATFbits.LATF8)
//		#define ENC100_SCK_AL_TRIS				(TRISFbits.TRISF6)
//	#elif defined ENC_IN_SPI2
//		#define ENC100_CS_TRIS					(TRISFbits.TRISF12)
//		#define ENC100_CS_IO					(LATFbits.LATF12)
//		#define ENC100_POR_TRIS					(TRISFbits.TRISF13)
//		#define ENC100_POR_IO					(LATFbits.LATF13)
//		#define ENC100_SO_WR_B0SEL_EN_TRIS		(TRISGbits.TRISG7)	// NOTE: SO is ENC624J600 Serial Out, which needs to connect to the PIC SDI pin for SPI mode
//		#define ENC100_SO_WR_B0SEL_EN_IO		(PORTGbits.RG7)
//		#define ENC100_SI_RD_RW_TRIS			(TRISGbits.TRISG8)	// NOTE: SI is ENC624J600 Serial In, which needs to connect to the PIC SDO pin for SPI mode
//		#define ENC100_SI_RD_RW_IO				(LATGbits.LATG8)
//		#define ENC100_SCK_AL_TRIS				(TRISGbits.TRISG6)
//		#define ENC100_SCK_AL_IO				(PORTGbits.RG6)		// NOTE: This must be the PORT, not the LATch like it is for the PSP interface.
//	#endif
//#endif
//
//
//// ENC624J600 SPI SFR register selection (controls which SPI peripheral to 
//// use on PICs with multiple SPI peripherals).  If a parallel interface is 
//// used (ENC100_INTERFACE_MODE is >= 1), then the SPI is not used and this 
//// section can be ignored or deleted.
//#if defined ENC_IN_SPI1
//	#define ENC100_ISR_ENABLE		(IEC0bits.INT2IE)
//	#define ENC100_ISR_FLAG			(IFS0bits.INT2IF)
//	#define ENC100_ISR_POLARITY		(INTCONbits.INT2EP)
//	#define ENC100_ISR_PRIORITY		(IPC2bits.INT2IP)
//	#define ENC100_SPI_ENABLE		(ENC100_SPICON1bits.ON)
//	#define ENC100_SPI_IF			(IFS0bits.SPI1RXIF)
//	#define ENC100_SSPBUF			(SPI1BUF)
//	#define ENC100_SPICON1			(SPI1CON)
//	#define ENC100_SPISTATbits		(SPI1STATbits)
//	#define ENC100_SPICON1bits		(SPI1CONbits)
//	#define ENC100_SPIBRG			(SPI1BRG)
//#elif defined ENC_IN_SPI2
//	#define ENC100_ISR_ENABLE		(IEC0bits.INT4IE)
//	#define ENC100_ISR_FLAG			(IFS0bits.INT4IF)
//	#define ENC100_ISR_POLARITY		(INTCONbits.INT4EP)
//	#define ENC100_ISR_PRIORITY		(IPC2bits.INT4IP)
//	#define ENC100_SPI_ENABLE		(ENC100_SPICON1bits.ON)
//	#define ENC100_SPI_IF			(IFS1bits.SPI2RXIF)
//	#define ENC100_SSPBUF			(SPI2BUF)
//	#define ENC100_SPICON1			(SPI2CON)
//	#define ENC100_SPISTATbits		(SPI2STATbits)
//	#define ENC100_SPICON1bits		(SPI2CONbits)
//	#define ENC100_SPIBRG			(SPI2BRG)
//#endif


////----------------------------
//// MRF24WB0M WiFi I/O pins
////----------------------------
//// If you have a MRF24WB0M WiFi PICtail, you must uncomment one of 
//// these two lines to use it.  SPI1 is the top-most slot while SPI2 corresponds to 
//// insertion of the PICtail into the middle of the side edge connector slot.
//
//#define MRF24WB0M_IN_SPI1
////#define MRF24WB0M_IN_SPI2
//#if defined(MRF24WB0M_IN_SPI1)
//	// MRF24WB0M in SPI1 slot
//	#define WF_CS_TRIS			(TRISBbits.TRISB2)
//	#define WF_CS_IO			(LATBbits.LATB2)
//	#define WF_SDI_TRIS			(TRISFbits.TRISF7)
//	#define WF_SCK_TRIS			(TRISFbits.TRISF6)
//	#define WF_SDO_TRIS			(TRISFbits.TRISF8)
//	#define WF_RESET_TRIS		(TRISFbits.TRISF0)
//	#define WF_RESET_IO			(LATFbits.LATF0)
//	#define WF_INT_TRIS			(TRISEbits.TRISE8)	// INT1
//	#define WF_INT_IO			(PORTEbits.RE8)
//	#define WF_HIBERNATE_TRIS	(TRISFbits.TRISF1)
//	#define WF_HIBERNATE_IO		(PORTFbits.RF1)
//	#define WF_INT_EDGE			(INTCONbits.INT1EP)
//	#define WF_INT_IE			(IEC0bits.INT1IE)
//	#define WF_INT_IF			(IFS0bits.INT1IF)
//	#define WF_INT_IE_CLEAR		IEC0CLR
//	#define WF_INT_IF_CLEAR		IFS0CLR
//	#define WF_INT_IE_SET		IEC0SET
//	#define WF_INT_IF_SET		IFS0SET
//	#define WF_INT_BIT			0x00000080
//	#define WF_INT_IPCSET		IPC1SET
//	#define WF_INT_IPCCLR		IPC1CLR
//	#define WF_INT_IPC_MASK		0xFF000000
//	#define WF_INT_IPC_VALUE	0x0C000000
//
//	#define WF_SSPBUF			(SPI1BUF)
//	#define WF_SPISTAT			(SPI1STAT)
//	#define WF_SPISTATbits		(SPI1STATbits)
//	#define WF_SPICON1			(SPI1CON)
//	#define WF_SPICON1bits		(SPI1CONbits)
//	#define WF_SPI_IE_CLEAR		IEC0CLR
//	#define WF_SPI_IF_CLEAR		IFS0CLR
//	#define WF_SPI_INT_BITS		0x03800000
//	#define WF_SPI_BRG			(SPI1BRG)
//	#define WF_MAX_SPI_FREQ		(10000000ul)	// Hz
//
//#elif defined(MRF24WB0M_IN_SPI2)
//	// MRF24WB0M in SPI2 slot
//	#define WF_CS_TRIS			(TRISGbits.TRISG9)
//	#define WF_CS_IO			(LATGbits.LATG9)
//	#define WF_SDI_TRIS			(TRISGbits.TRISG7)
//	#define WF_SCK_TRIS			(TRISGbits.TRISG6)
//	#define WF_SDO_TRIS			(TRISGbits.TRISG8)
//	#define WF_RESET_TRIS		(TRISGbits.TRISG0)
//	#define WF_RESET_IO			(LATGbits.LATG0)
//	#define WF_INT_TRIS			(TRISAbits.TRISA14)	// INT3
//	#define WF_INT_IO			(PORTAbits.RA14)
//	#define WF_HIBERNATE_TRIS	(TRISGbits.TRISG1)
//	#define WF_HIBERNATE_IO		(PORTGbits.RG1)
//	#define WF_INT_EDGE			(INTCONbits.INT3EP)
//	#define WF_INT_IE			(IEC0bits.INT3IE)
//	#define WF_INT_IF			(IFS0bits.INT3IF)
//	#define WF_INT_IE_CLEAR		IEC0CLR
//	#define WF_INT_IF_CLEAR		IFS0CLR
//	#define WF_INT_IE_SET		IEC0SET
//	#define WF_INT_IF_SET		IFS0SET
//	#define WF_INT_BIT			0x00008000
//	#define WF_INT_IPCSET		IPC3SET
//	#define WF_INT_IPCCLR		IPC3CLR
//	#define WF_INT_IPC_MASK		0xFF000000
//	#define WF_INT_IPC_VALUE	0x0C000000
//
//	#define WF_SSPBUF			(SPI2BUF)
//	#define WF_SPISTAT			(SPI2STAT)
//	#define WF_SPISTATbits		(SPI2STATbits)
//	#define WF_SPICON1			(SPI2CON)
//	#define WF_SPICON1bits		(SPI2CONbits)
//	#define WF_SPI_IE_CLEAR		IEC1CLR
//	#define WF_SPI_IF_CLEAR		IFS1CLR
//	#define WF_SPI_INT_BITS		0x000000e0
//	#define WF_SPI_BRG			(SPI2BRG)
//	#define WF_MAX_SPI_FREQ		(10000000ul)	// Hz
//#endif


#endif // #ifndef HARDWARE_PROFILE_H
