AleSuky/SkP32v1.1/SW/Ejemplos/TestModbus/main.c

#include <p32xxxx.h>
#include <plib.h>
// *--------------------------------------------------------------------------------*
// Cristal de 4MHz.-
// SYSCLK = 80 MHz (4MHz Cristal/ FPLLIDIV * FPLLMUL / FPLLODIV)
// FPLLDIV 1:1, PLLMULT x20, PLLODIV 1:1. -> 80MHz
// FPBDIV 1:1 -> 80MHz
#pragma config FPLLODIV=DIV_1, FPLLIDIV=DIV_2, FPLLMUL=MUL_20, FPBDIV=DIV_1
#pragma config FWDTEN=OFF, FCKSM=CSDCMD, POSCMOD=XT, FNOSC=PRIPLL
#pragma config UPLLEN=ON, UPLLIDIV=DIV_2
#pragma config CP=OFF, BWP=OFF, PWP=OFF
// *--------------------------------------------------------------------------------*
#include "HardwareProfile.h"
#include "mb.h"
// *--------------------------------------------------------------------------------*
#define REG_INPUT_START         1000
#define REG_INPUT_NREGS         4
#define REG_HOLDING_START       2000
#define REG_HOLDING_NREGS       100
// *--------------------------------------------------------------------------------*
static USHORT   usRegInputStart = REG_INPUT_START;
static USHORT   usRegInputBuf[REG_INPUT_NREGS];
static USHORT   usRegHoldingStart = REG_HOLDING_START;
static USHORT   usRegHoldingBuf[REG_HOLDING_NREGS];
// *--------------------------------------------------------------------------------*
int main(){
    UINT32 Count=0x3FFFF;
    mJTAGPortEnable(0);							// JTAG des-habilitado
    SYSTEMConfigPerformance(GetSystemClock()); 	// Activa pre-cache.-

    LED1_OUTPUT();
    LED2_OUTPUT();
    LED3_OUTPUT();
    LED4_OUTPUT();

    LED1_OFF();LED2_OFF();LED3_OFF();LED4_OFF();

    SW1_INPUT();
    SW2_INPUT();


    eMBInit( MB_ASCII, 0x01, 0, 19200, MB_PAR_NONE );
    //eMBInit( MB_RTU, 0x01, 0, 19200, MB_PAR_NONE );
    eMBEnable(  );
    while(1){
        ( void )eMBPoll(  );
        if(--Count==0){
            Count=0x3FFFF;
            LED1_TOGGLE();
        }
    }
}
// *--------------------------------------------------------------------------------*
eMBErrorCode
eMBRegInputCB( UCHAR * pucRegBuffer, USHORT usAddress, USHORT usNRegs )
{
    eMBErrorCode    eStatus = MB_ENOERR;
    int             iRegIndex;

    if( ( usAddress >= REG_INPUT_START )
        && ( usAddress + usNRegs <= REG_INPUT_START + REG_INPUT_NREGS ) )
    {
        iRegIndex = ( int )( usAddress - usRegInputStart );
        while( usNRegs > 0 )
        {
            *pucRegBuffer++ =
                ( unsigned char )( usRegInputBuf[iRegIndex] >> 8 );
            *pucRegBuffer++ =
                ( unsigned char )( usRegInputBuf[iRegIndex] & 0xFF );
            iRegIndex++;
            usNRegs--;
        }
    }
    else
    {
        eStatus = MB_ENOREG;
    }

    return eStatus;
}
// *--------------------------------------------------*
eMBErrorCode
eMBRegHoldingCB( UCHAR * pucRegBuffer, USHORT usAddress, USHORT usNRegs,
                 eMBRegisterMode eMode )
{
    eMBErrorCode    eStatus = MB_ENOERR;
    int             iRegIndex;

    if( ( usAddress >= REG_HOLDING_START ) &&
        ( usAddress + usNRegs <= REG_HOLDING_START + REG_HOLDING_NREGS ) )
    {
        iRegIndex = ( int )( usAddress - usRegHoldingStart );
        switch ( eMode )
        {
            /* Pass current register values to the protocol stack. */
        case MB_REG_READ:
            while( usNRegs > 0 )
            {
                *pucRegBuffer++ = ( UCHAR ) ( usRegHoldingBuf[iRegIndex] >> 8 );
                *pucRegBuffer++ = ( UCHAR ) ( usRegHoldingBuf[iRegIndex] & 0xFF );
                iRegIndex++;
                usNRegs--;
            }
            break;

            /* Update current register values with new values from the
             * protocol stack. */
        case MB_REG_WRITE:
            while( usNRegs > 0 )
            {
                usRegHoldingBuf[iRegIndex] = *pucRegBuffer++ << 8;
                usRegHoldingBuf[iRegIndex] |= *pucRegBuffer++;
                iRegIndex++;
                usNRegs--;
            }
        }
    }
    else
    {
        eStatus = MB_ENOREG;
    }
    return eStatus;
}
// *--------------------------------------------------*

eMBErrorCode
eMBRegCoilsCB( UCHAR * pucRegBuffer, USHORT usAddress, USHORT usNCoils,
               eMBRegisterMode eMode )
{
    return MB_ENOREG;
}
// *--------------------------------------------------*
eMBErrorCode
eMBRegDiscreteCB( UCHAR * pucRegBuffer, USHORT usAddress, USHORT usNDiscrete )
{
    return MB_ENOREG;
}
