AleSuky/SkP32v1.1/SW/Ejemplos/USB-HOST_Mass_Storage/main.c

#include <p32xxxx.h>
#include <plib.h>
// *--------------------------------------------------------------------------------*
// Cristal de 4MHz.-
// SYSCLK = 80 MHz (4MHz Cristal/ FPLLIDIV * FPLLMUL / FPLLODIV)
// FPLLDIV 1:1, PLLMULT x20, PLLODIV 1:1. -> 80MHz
// FPBDIV 1:1 -> 80MHz
#pragma config FPLLODIV=DIV_1, FPLLIDIV=DIV_2, FPLLMUL=MUL_20, FPBDIV=DIV_1
#pragma config FWDTEN=OFF, FCKSM=CSDCMD, POSCMOD=XT, FNOSC=PRIPLL
#pragma config UPLLEN=ON, UPLLIDIV=DIV_2
#pragma config CP=OFF, BWP=OFF, PWP=OFF
// *--------------------------------------------------------------------------------*
#include "HardwareProfile.h"
#include "USB/usb.h"
#include "USB/usb_host_msd.h"
#include "USB/usb_host_msd_scsi.h"
#include "MDD File System/FSIO.h"
// *--------------------------------------------------------------------------------*
FSFILE * myFile;
BYTE myData[512];
size_t numBytes;
volatile BOOL deviceAttached;
// *--------------------------------------------------------------------------------*
int main(){
	UINT16 Count=0;
	
    mJTAGPortEnable(0);							// JTAG des-habilitado
	SYSTEMConfigPerformance(GetSystemClock()); 	// Activa pre-cache.-
	
	LED1_OUTPUT();
	LED2_OUTPUT();
	INTEnableSystemMultiVectoredInt();
	deviceAttached = FALSE;
    //Initialize the stack
    USBInitialize(0);
    
	while(1){
		//USB stack process function
        USBTasks();
		if(++Count==0){
			LED1_TOGGLE();
		}
        //if thumbdrive is plugged in
        if(USBHostMSDSCSIMediaDetect()){
            deviceAttached = TRUE;
            LED1_OFF();
            //now a device is attached
            //See if the device is attached and in the right format
            if(FSInit()){
                //Opening a file in mode "w" will create the file if it doesn't
                //  exist.  If the file does exist it will delete the old file
                //  and create a new one that is blank.
                myFile = FSfopen("test.txt","w");

                //Write some data to the new file.
                FSfwrite("This is a test.",1,15,myFile);                

                //Always make sure to close the file so that the data gets
                //  written to the drive.
                FSfclose(myFile);

                //Just sit here until the device is removed.
                while(deviceAttached == TRUE){
                    USBTasks();
                    if(++Count==0){
						LED2_TOGGLE();
					}
                }
                LED2_OFF();
            }
        }
	}
}
/****************************************************************************
  Function:
    BOOL USB_ApplicationEventHandler( BYTE address, USB_EVENT event,
                void *data, DWORD size )

  Summary:
    This is the application event handler.  It is called when the stack has
    an event that needs to be handled by the application layer rather than
    by the client driver.

  Description:
    This is the application event handler.  It is called when the stack has
    an event that needs to be handled by the application layer rather than
    by the client driver.  If the application is able to handle the event, it
    returns TRUE.  Otherwise, it returns FALSE.

  Precondition:
    None

  Parameters:
    BYTE address    - Address of device where event occurred
    USB_EVENT event - Identifies the event that occured
    void *data      - Pointer to event-specific data
    DWORD size      - Size of the event-specific data

  Return Values:
    TRUE    - The event was handled
    FALSE   - The event was not handled

  Remarks:
    The application may also implement an event handling routine if it
    requires knowledge of events.  To do so, it must implement a routine that
    matches this function signature and define the USB_HOST_APP_EVENT_HANDLER
    macro as the name of that function.
  ***************************************************************************/

BOOL USB_ApplicationEventHandler( BYTE address, USB_EVENT event, void *data, DWORD size )
{
    switch( event )
    {
        case EVENT_VBUS_REQUEST_POWER:
            // The data pointer points to a byte that represents the amount of power
            // requested in mA, divided by two.  If the device wants too much power,
            // we reject it.
            return TRUE;

        case EVENT_VBUS_RELEASE_POWER:
            // Turn off Vbus power.
            // The PIC24F with the Explorer 16 cannot turn off Vbus through software.

            //This means that the device was removed
            deviceAttached = FALSE;
            return TRUE;
            break;

        case EVENT_HUB_ATTACH:
            return TRUE;
            break;

        case EVENT_UNSUPPORTED_DEVICE:
            return TRUE;
            break;

        case EVENT_CANNOT_ENUMERATE:
            //UART2PrintString( "\r\n***** USB Error - cannot enumerate device *****\r\n" );
            return TRUE;
            break;

        case EVENT_CLIENT_INIT_ERROR:
            //UART2PrintString( "\r\n***** USB Error - client driver initialization error *****\r\n" );
            return TRUE;
            break;

        case EVENT_OUT_OF_MEMORY:
            //UART2PrintString( "\r\n***** USB Error - out of heap memory *****\r\n" );
            return TRUE;
            break;

        case EVENT_UNSPECIFIED_ERROR:   // This should never be generated.
            //UART2PrintString( "\r\n***** USB Error - unspecified *****\r\n" );
            return TRUE;
            break;

        default:
            break;
    }

    return FALSE;
}
