AleSuky/SkP32v1.1/SW/Ejemplos/Board Support Package/M25P80.c

/*****************************************************************************
 *
 * Basic access to SPI Flash SST25VF016 and M25P80
 *
 *****************************************************************************
 * FileName:        M25P80.c
 * Dependencies:    M25P80.h
 * Processor:       PIC24F, PIC24H, dsPIC, PIC32
 * Compiler:       	MPLAB C30 V3.00, MPLAB C32
 * Linker:          MPLAB LINK30, MPLAB LINK32
 * Company:         Microchip Technology Incorporated
 *
 * Software License Agreement
 *
 * Copyright © 2011 Microchip Technology Inc.  All rights reserved.
 * Microchip licenses to you the right to use, modify, copy and distribute
 * Software only when embedded on a Microchip microcontroller or digital
 * signal controller, which is integrated into your product or third party
 * product (pursuant to the sublicense terms in the accompanying license
 * agreement).  
 *
 * You should refer to the license agreement accompanying this Software
 * for additional information regarding your rights and obligations.
 *
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
 * Date        Comment
 *~~~~~~~~~~~~~~~~~~~~~~~~~~~~~~~~~~~~~~~~~~~~~~~~~~~~~~~~~~~~~~~~~~~~~~~~~~~~
 * 01/07/09	   ...
 * 03/08/11    - Modified header file dependencies
 *             - Abstracted out SPI component 
 * 05/11/11    - Updated this file to support both SST25VF016 and M25P80 families
 *             - Although the file name is still specific for M25P80
 *****************************************************************************/
#include "HardwareProfile.h"

#if defined (USE_SST25VF016) || defined(USE_M25P80)

#include "Compiler.h"
#include "GenericTypeDefs.h"
#include "drv_spi.h"
#include "M25P80.h"

/************************************************************************
* SST25 Commands                                                       
************************************************************************/
    #define SST25_CMD_READ  (unsigned)0x03
    #define SST25_CMD_WRITE (unsigned)0x02
    #define SST25_CMD_WREN  (unsigned)0x06
    #define SST25_CMD_RDSR  (unsigned)0x05
    #define SST25_CMD_ERASE (unsigned)0x60
	
    #if defined(USE_M25P80)
      #define SST25_CMD_EWSR  (unsigned)0x06
      #define SST25_CMD_SER   (unsigned)0xD8
    #elif defined(USE_SST25VF016)
      #define SST25_CMD_EWSR  (unsigned)0x50
      #define SST25_CMD_SER   (unsigned)0x20
	#else
	  #error "EWSR and SER commands not defined for the selected Serial flash."
    #endif
    
    #define SST25_CMD_WRSR  (unsigned)0x01

static DRV_SPI_INIT_DATA spiInitData;

/************************************************************************
* Function: SST25Init                                                  
*                                                                       
* Overview: this function setup SPI and IOs connected to SST25
*                                                                       
* Input: none                                                          
*                                                                       
* Output: none
*                                                                       
************************************************************************/
void SST25Init(DRV_SPI_INIT_DATA *pInitData)
{
    // initialize the SPI channel to be used
    // SPI_CHANNEL_USED is defined in the hardware profile
    DRV_SPI_Initialize(pInitData->channel, pInitData);
    memcpy(&spiInitData, pInitData, sizeof(DRV_SPI_INIT_DATA));

    SST25ResetWriteProtection();
}

/************************************************************************
* Function: void SST25WriteByte(BYTE data, DWORD address)                                           
*                                                                       
* Overview: this function writes a byte to the address specified
*                                                                       
* Input: data to be written and address
*                                                                       
* Output: none                                 
*                                                                       
************************************************************************/
void SST25WriteByte(BYTE data, DWORD address)
{
    SST25WriteEnable();

    while(!SPILock(spiInitData.channel))
        ;

    DRV_SPI_Initialize(spiInitData.channel, (DRV_SPI_INIT_DATA *)&spiInitData);

    SST25CSLow();

    SPIPut(spiInitData.channel, SST25_CMD_WRITE);
    SPIGet(spiInitData.channel);

    SPIPut(spiInitData.channel, ((DWORD_VAL) address).v[2]);
    SPIGet(spiInitData.channel);

    SPIPut(spiInitData.channel, ((DWORD_VAL) address).v[1]);
    SPIGet(spiInitData.channel);

    SPIPut(spiInitData.channel, ((DWORD_VAL) address).v[0]);
    SPIGet(spiInitData.channel);

    SPIPut(spiInitData.channel, data);
    SPIGet(spiInitData.channel);

    SST25CSHigh();

    SPIUnLock(spiInitData.channel);

    // Wait for write end
    while(SST25IsWriteBusy());
}

/************************************************************************
* Function: BYTE SST25ReadByte(DWORD address)             
*                                                                       
* Overview: this function reads a byte from the address specified         
*                                                                       
* Input: address                                                     
*                                                                       
* Output: data read
*                                                                       
************************************************************************/
BYTE SST25ReadByte(DWORD address)
{
    BYTE    temp;
    
    while(!SPILock(spiInitData.channel))
        ;
    
    DRV_SPI_Initialize(spiInitData.channel, (DRV_SPI_INIT_DATA *)&spiInitData);

    SST25CSLow();

    SPIPut(spiInitData.channel, SST25_CMD_READ);
    SPIGet(spiInitData.channel);

    SPIPut(spiInitData.channel, ((DWORD_VAL) address).v[2]);
    SPIGet(spiInitData.channel);

    SPIPut(spiInitData.channel, ((DWORD_VAL) address).v[1]);
    SPIGet(spiInitData.channel);

    SPIPut(spiInitData.channel, ((DWORD_VAL) address).v[0]);
    SPIGet(spiInitData.channel);

    SPIPut(spiInitData.channel, 0);
    temp = SPIGet(spiInitData.channel);

    SST25CSHigh();

    SPIUnLock(spiInitData.channel);

    return (temp);
}

/************************************************************************
* Function: void SST25WriteWord(WODR data, DWORD address)                                           
*                                                                       
* Overview: this function writes a 16-bit word to the address specified
*                                                                       
* Input: data to be written and address
*                                                                       
* Output: none                                                         
*                                                                       
************************************************************************/
void SST25WriteWord(WORD data, DWORD address)
{
    SST25WriteByte(((WORD_VAL) data).v[0], address);
    SST25WriteByte(((WORD_VAL) data).v[1], address + 1);
}

/************************************************************************
* Function: WORD SST25ReadWord(DWORD address)             
*                                                                       
* Overview: this function reads a 16-bit word from the address specified         
*                                                                       
* Input: address                                                     
*                                                                       
* Output: data read
*                                                                       
************************************************************************/
WORD SST25ReadWord(DWORD address)
{
    WORD_VAL    temp;

    temp.v[0] = SST25ReadByte(address);
    temp.v[1] = SST25ReadByte(address + 1);

    return (temp.Val);
}

/************************************************************************
* Function: SST25WriteEnable()                                         
*                                                                       
* Overview: this function allows write/erase SST25. Must be called  
* before every write/erase command.                                         
*                                                                       
* Input: none                                                          
*                                                                       
* Output: none                                 
*                                                                       
************************************************************************/
void SST25WriteEnable(void)
{
    while(!SPILock(spiInitData.channel))
        ;
    
    DRV_SPI_Initialize(spiInitData.channel, (DRV_SPI_INIT_DATA *)&spiInitData);

    SST25CSLow();
    SPIPut(spiInitData.channel, SST25_CMD_WREN);
    SPIGet(spiInitData.channel);
    SST25CSHigh();
    SPIUnLock(spiInitData.channel);
}

/************************************************************************
* Function: BYTE SST25IsWriteBusy(void)  
*                                                                       
* Overview: this function reads status register and chek BUSY bit for write operation
*                                                                       
* Input: none                                                          
*                                                                       
* Output: non zero if busy
*                                                                       
************************************************************************/
BYTE SST25IsWriteBusy(void)
{
    BYTE    temp;

    while(!SPILock(spiInitData.channel))
        ;

    DRV_SPI_Initialize(spiInitData.channel, (DRV_SPI_INIT_DATA *)&spiInitData);

    SST25CSLow();
    SPIPut(spiInitData.channel, SST25_CMD_RDSR);
    SPIGet(spiInitData.channel);

    SPIPut(spiInitData.channel, 0);
    temp = SPIGet(spiInitData.channel);
    SST25CSHigh();
    SPIUnLock(spiInitData.channel);

    return (temp & 0x01);
}

/************************************************************************
* Function: BYTE SST25WriteArray(DWORD address, BYTE* pData, nCount)
*                                                                       
* Overview: this function writes a data array at the address specified
*                                                                       
* Input: flash memory address, pointer to the data array, data number
*                                                                       
* Output: return 1 if the operation was successfull
*                                                                     
************************************************************************/
BYTE SST25WriteArray(DWORD address, BYTE *pData, WORD nCount)
{
    DWORD   addr;
    BYTE    *pD;
    WORD    counter;

    addr = address;
    pD = pData;

    // WRITE
    for(counter = 0; counter < nCount; counter++)
    {
        SST25WriteByte(*pD++, addr++);
    }

    // VERIFY
    for(counter = 0; counter < nCount; counter++)
    {
        if(*pData != SST25ReadByte(address))
            return (0);
        pData++;
        address++;
    }

    return (1);
}

/************************************************************************
* Function: void SST25ReadArray(DWORD address, BYTE* pData, nCount)
*                                                                       
* Overview: this function reads data into buffer specified
*                                                                       
* Input: flash memory address, pointer to the data buffer, data number
*                                                                       
************************************************************************/
void SST25ReadArray(DWORD address, BYTE *pData, WORD nCount)
{
    while(!SPILock(spiInitData.channel))
        ;

    DRV_SPI_Initialize(spiInitData.channel, (DRV_SPI_INIT_DATA *)&spiInitData);

    SST25CSLow();

    SPIPut(spiInitData.channel, SST25_CMD_READ);
    SPIGet(spiInitData.channel);

    SPIPut(spiInitData.channel, ((DWORD_VAL) address).v[2]);
    SPIGet(spiInitData.channel);

    SPIPut(spiInitData.channel, ((DWORD_VAL) address).v[1]);
    SPIGet(spiInitData.channel);

    SPIPut(spiInitData.channel, ((DWORD_VAL) address).v[0]);
    SPIGet(spiInitData.channel);

    while(nCount--)
    {
        SPIPut(spiInitData.channel, 0);
        *pData++ = SPIGet(spiInitData.channel);
    }

    SST25CSHigh();
    SPIUnLock(spiInitData.channel);
}

/************************************************************************
* Function: void SST25ChipErase(void)
*                                                                       
* Overview: chip erase
*                                                                       
* Input: none
*                                                                       
************************************************************************/
void SST25ChipErase(void)
{
    SST25WriteEnable();

    while(!SPILock(spiInitData.channel))
        ;

    DRV_SPI_Initialize(spiInitData.channel, (DRV_SPI_INIT_DATA *)&spiInitData);
    SST25CSLow();

    SPIPut(spiInitData.channel, SST25_CMD_ERASE);
    SPIGet(spiInitData.channel);

    SST25CSHigh();
    SPIUnLock(spiInitData.channel);

    // Wait for write end
    while(SST25IsWriteBusy());
}

/************************************************************************
* Function: void SST25ResetWriteProtection()
*                                                                       
* Overview: this function reset write protection bits
*                                                                       
* Input: none                                                     
*                                                                       
* Output: none
*                                                                       
************************************************************************/
void SST25ResetWriteProtection(void)
{
    while(!SPILock(spiInitData.channel))
        ;
    
    DRV_SPI_Initialize(spiInitData.channel, (DRV_SPI_INIT_DATA *)&spiInitData);

    SST25CSLow();

    SPIPut(spiInitData.channel, SST25_CMD_EWSR);
    SPIGet(spiInitData.channel);

    SST25CSHigh();

    SST25CSLow();

    SPIPut(spiInitData.channel, SST25_CMD_WRSR);
    SPIGet(spiInitData.channel);

    SPIPut(spiInitData.channel, 0);
    SPIGet(spiInitData.channel);

    SST25CSHigh();
    SPIUnLock(spiInitData.channel);

    // Wait for write end
    while(SST25IsWriteBusy());
}

/************************************************************************
* Function: void SST25SectorErase(DWORD address)                                           
*                                                                       
* Overview: this function erases a 4Kb sector
*                                                                       
* Input: address within sector to be erased
*                                                                       
* Output: none                                 
*                                                                       
************************************************************************/
void SST25SectorErase(DWORD address)
{
    SST25WriteEnable();
    
    while(!SPILock(spiInitData.channel))
        ;

    DRV_SPI_Initialize(spiInitData.channel, (DRV_SPI_INIT_DATA *)&spiInitData);

    SST25CSLow();

    SPIPut(spiInitData.channel, SST25_CMD_SER);
    SPIGet(spiInitData.channel);

    SPIPut(spiInitData.channel, ((DWORD_VAL) address).v[2]);
    SPIGet(spiInitData.channel);

    SPIPut(spiInitData.channel, ((DWORD_VAL) address).v[1]);
    SPIGet(spiInitData.channel);

    SPIPut(spiInitData.channel, ((DWORD_VAL) address).v[0]);
    SPIGet(spiInitData.channel);

    SST25CSHigh();
    SPIUnLock(spiInitData.channel);

    // Wait for write end
    while(SST25IsWriteBusy());
}

#endif // #if defined (USE_SST25VF016) || defined(USE_M25P80)
