AleSuky/SkP32v1.1/SW/Ejemplos/Board Support Package/SST39LF400.c

/*****************************************************************************
 *
 * Basic access to parallel FLASH SST39LF400.
 *
 *****************************************************************************
 * FileName:        SST39LF400.c
 * Dependencies:    SST39LF400.h
 * Processor:       PIC24F
 * Compiler:       	MPLAB C30 V3.00
 * Linker:          MPLAB LINK30
 * Company:         Microchip Technology Incorporated
 *
 * Software License Agreement
 *
 * Copyright © 2009 Microchip Technology Inc.  All rights reserved.
 * Microchip licenses to you the right to use, modify, copy and distribute
 * Software only when embedded on a Microchip microcontroller or digital
 * signal controller, which is integrated into your product or third party
 * product (pursuant to the sublicense terms in the accompanying license
 * agreement).  
 *
 * You should refer to the license agreement accompanying this Software
 * for additional information regarding your rights and obligations.
 *
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
 * Date         Comment
 *~~~~~~~~~~~~~~~~~~~~~~~~~~~~~~~~~~~~~~~~~~~~~~~~~~~~~~~~~~~~~~~~~~~~
 * 4/12/2010	Original, ported from SST39LF400A
 * 8/11/2010	Removed dependency on Graphics file. 
 * 1/14/2011    Implemented read and write function using EDS access.
 *              Swapped SST39LF400WriteWord() parameters for consistency
 *              with other drivers.
 * 5/25/2011    Modified WriteArray and ReadArray functions to match
 *              common interface for other external flash drivers.
 ********************************************************************/
#include "SST39LF400.h"

#if defined (USE_SST39LF400)

#include "Graphics/gfxepmp.h"

#define  	CS2_BASE_ADDRESS   		GFX_EPMP_CS2_BASE_ADDRESS  
#define 	SST39LF400_FLASH_SIZE	0x00400000ul

// dummy declaration for EPMP CS2 start address 
__eds__ WORD __attribute__((eds, noload, address(CS2_BASE_ADDRESS))) EPMPCS2Start;

/************************************************************************
*   LOCAL PROTOTYPES
************************************************************************/
void lWrite16(DWORD address, WORD data);
WORD lRead16(DWORD address);


/************************************************************************
* Function: SST39LF400Init()                                                 
*                                                                       
* Overview: This function initializes IOs and Parallel Master Port. 
*                                                                       
* Input: Address of the array for the current EPMP SFR register
*		 contents. 
*                                                                       
* Output: none
*                                                                       
************************************************************************/
void SST39LF400Init()
{
    
    DriverInterfaceInit();

}

/************************************************************************
* Function: BYTE SST39LV400WriteWord(DWORD address, WORD data)
*                                                                       
* Overview: this function writes one word
*                                                                       
* Input: address and word to be written
*                                                                       
* Output: non-zero if it's successful
*
* Notes: none
*                                                                       
************************************************************************/
BYTE SST39LF400WriteWord(WORD data, DWORD address)
{
	WORD temp;
	
    lWrite16(0x000005555,0x00aa);
    lWrite16(0x000002aaa,0x0055);
    lWrite16(0x000005555,0x00a0);
    lWrite16(address,data);
    
    SST39LF400WaitProgram();

    if((temp = SST39LF400ReadWord(address)) == data)
        if((temp = SST39LF400ReadWord(address)) == data)
            return (1);

    return (0); // failed
}

/************************************************************************
* Function: WORD SST39LF400ReadWord(DWORD address)
*                                                                       
* Overview: this function reads a word from address specified         
*                                                                       
* Input: address                                                     
*                                                                       
* Output: data read
*                                                                       
************************************************************************/
WORD SST39LF400ReadWord(DWORD address)
{
WORD temp;
	
	temp = lRead16(address);

    return (temp);
}
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
