AleSuky/SkP32v1.1/(commit log)

2013-01-28 Se agrega documentacion, esquemas y plantilla de ejemplo
    [PIC32.GBL, PIC32.GBO, PIC32.GBP, PIC32.GBS, PIC32.GTL, PIC32.GTO, PIC32.GTP, PIC32.GTS]
2013-01-28 Se agregan ejemplos
    [Printer Study.xls, Printers.xls]
2013-04-12 Actualizar main.c para cristal de 8 MHz
2013-08-31 Se agrega ejemplo utilizando freeMODBUS utilizando UART2 (ASCII y RTU probados)
2013-09-01 Se agrega proyecto para utilización FatFS by ChaN
